V128Team/hardware/keyboard/README.org

#+CAPTION: V128 Keyboard preview
#+NAME: fig:keyboard-preview
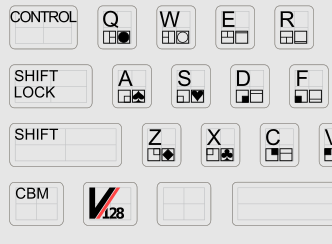
[picture p10: keyboard/keyboard-preview.png]


* What is this?

This directory contains the keyboard layouts necessary to create a custom v128
mechanical USB keyboard for use with a v128 Home Computer system. These layouts
are designed using the [[wasdkeyboards.com][wasd Keyboards]] keyboard templates, and should be usable
directly in their [[https://www.wasdkeyboards.com/wasd-v3-104-key-custom-mechanical-keyboard.html][custom keyboard designer]].

Note that these are designed for the "WASD V3 104-Key Custom Mechanical
Keyboard" in the US layout only.

You can purchase the v128 Keyboard here:
[[https://www.wasdkeyboards.com/v128-by-jtgans-104-key-v3-custom-mechanical-keyboard.html][https://www.wasdkeyboards.com/v128-by-jtgans-104-key-v3-custom-mechanical-keyboard.html]]
