V128Team/hardware/udoo-prototype/udoo-prototype.png

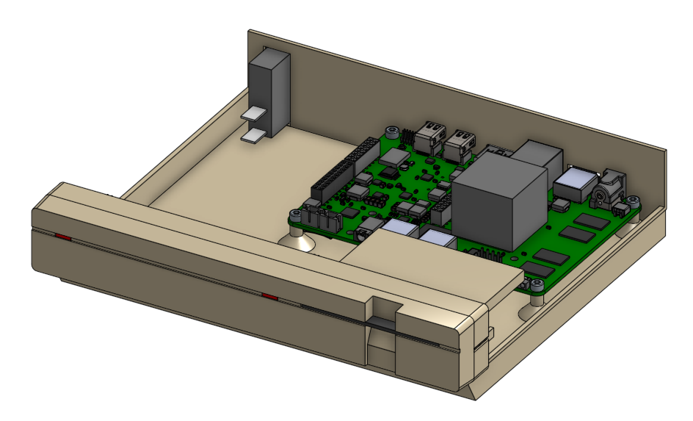
udoo-prototype/udoo-prototype.png
