V128Team/hardware/cm4-prototype/V=128 Case - V=128 Bottom.stl

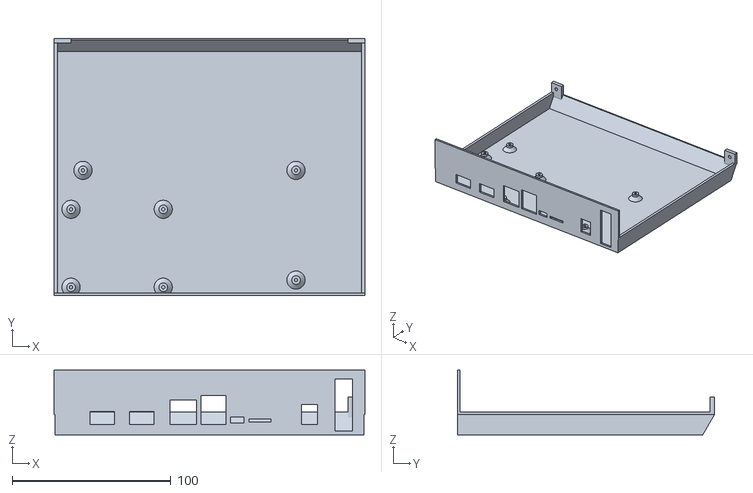
[picture p12: CAD file, 2021-05-29]
cm4-prototype/V=128 Case - V=128 Bottom.stl
195.6 x 161.8 x 40.6
