V128Team/hardware/cm4-prototype/V=128 Case - V=128 Top.stl

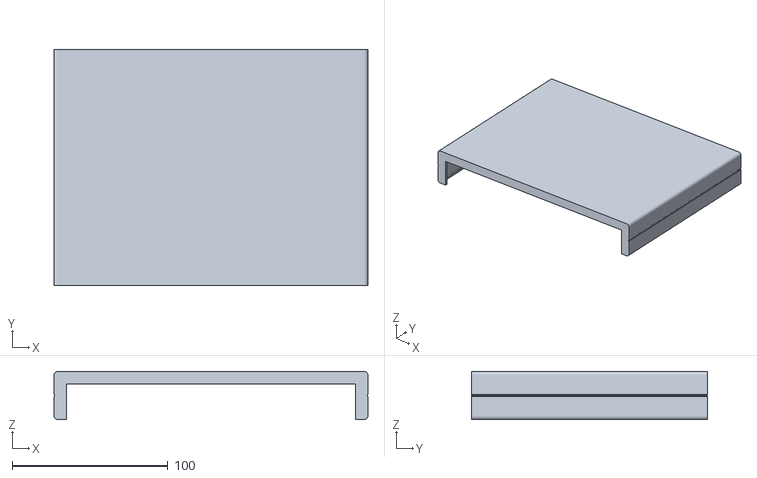
[picture p13: CAD file, 2020-11-02]
cm4-prototype/V=128 Case - V=128 Top.stl
201.6 x 151.7 x 30.8
