V128Team/hardware/cm4-prototype/Floppy Disk - NFC Lid.stl

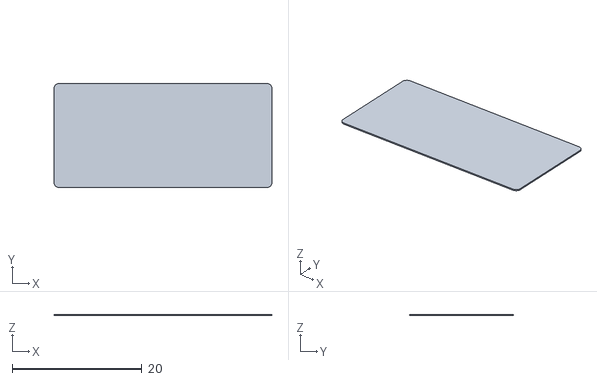
[picture p14: CAD file, 2020-11-02]
cm4-prototype/Floppy Disk - NFC Lid.stl
33.6 x 16.1 x 0.2
