V128Team/hardware/cm4-prototype/Floppy Disk - Disk.stl

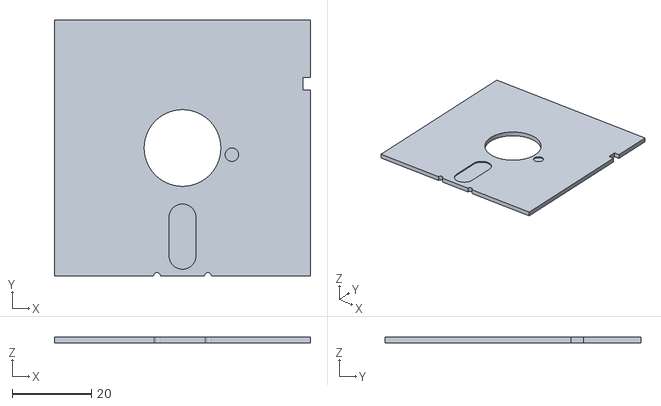
[picture p15: CAD file, 2020-11-02]
cm4-prototype/Floppy Disk - Disk.stl
64.5 x 64.5 x 1.50
