V128Team/hardware/cm4-prototype/V=128 Case - V=128 Front.stl

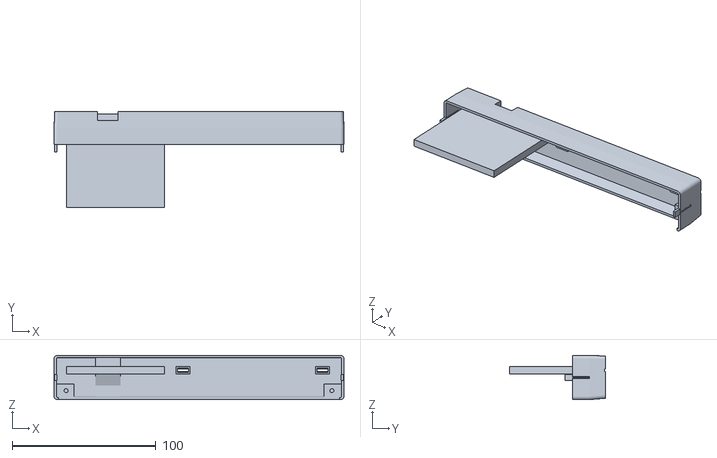
[picture p16: CAD file, 2020-11-02]
cm4-prototype/V=128 Case - V=128 Front.stl
201.6 x 67.0 x 30.8
