V128Team/hardware/(commit log)

2020-11-02 Adding in the udoo prototype case.
    [Floppy Disk - Disk.stl, Floppy Disk - NFC Lid.stl, V=128 Case - V=128 Bottom.stl, V=128 Case - V=128 Front.stl, V=128 Case - V=128 Top.stl]
2020-11-02 Add in the BOM and a short preview
2020-11-02 Add some additional 3D printing notes.
2020-11-07 Updating the BOM to match what is in the video
2021-05-29 Add in STLs for the CM4 prototype
    [Floppy Disk - Disk.stl, Floppy Disk - NFC Lid.stl, V=128 Case - V=128 Bottom.stl, V=128 Case - V=128 Front.stl, V=128 Case - V=128 Top.stl]
2021-05-29 Fix the bom list.
2021-05-29 Add printing instructions and filament source
